nicola-milani/babybox/hardware/kicad/README.md

# Schema KiCad

Mettere qui il progetto KiCad (`.kicad_pro`, `.kicad_sch`). Per la 1.0 serve solo lo schema, usato come riferimento per il montaggio su millefori. La PCB è fase successiva (M6).

Esportare anche un PDF dello schema in questa cartella a ogni modifica, così si legge senza KiCad.
