nicola-milani/babybox/PIANO_DI_LAVORO.md

# Piano di lavoro — consegna venerdì 20 novembre 2026

Partenza: sabato 17 ottobre 2026. Aggiornato **domenica 18 ottobre, sera**:
mancano **33 giorni**, poco meno di cinque settimane. L'ordine parte
**martedì 20**.

## Cosa significa "pronto" il 20 novembre

Un box completo e funzionante (milestone M1–M5 in versione essenziale):

- case in PETG chiuso, elettronica su millefori, batteria 18650 con ricarica USB-C;
- almeno **5 carte** con storie registrate e **3 dischi** con canzoni;
- firmware: carte, pausa/ripresa, cursore volume, tasti, deep sleep, web UI in italiano con pagina casa, controllo genitori;
- test d'uso con un bambino superato; repository pubblico con README e STL.

**Fuori dal 20 novembre** (dopo la 1.0): PCB custom, M6 kit per altre famiglie, esportazione "personaggio" in TAR se il tempo stringe.

**Non si fa:** nessuna pull request verso ESPuino o altri progetti altrui. Correzioni e traduzione restano nel fork.

## Dove siamo, in due righe

Il software è **avanti di due settimane** sul piano; l'hardware **non è ancora
partito**, perché l'ordine non è stato fatto. Tutto il rischio della consegna
si è concentrato in un punto solo: la data in cui arrivano i pezzi.

### Fatto nel fine settimana (17–18 ottobre)

| | |
| --- | --- |
| Repository | Progetto e fork di ESPuino, pubblici, con licenze (GPL-3.0 e CC BY-SA 4.0). 19 + 9 commit |
| Firmware | **Compila** per ESP32-S3 N16R8: RAM 15,3 %, flash 46,6 %, zero avvisi |
| Task 3 · italiano | **Finito** (era previsto per la settimana 1): 0 etichette non tradotte su 2426 |
| Task 6 · controllo genitori | **Software finito** (era previsto per la settimana 3): logica con 47 verifiche, innesto nel firmware, pagina web. Manca la prova sul box |
| Modelli 3D | **18 STL pronti**: cubo in 8 pezzi, disco, i due raccoglitori, provino NFC, calibro parti piccole, **più la console v2 in 5 pezzi** |
| Console v2 | **Completa e alla pari col cubo** (18 ott, sera): sostegni interni, sede della ferrite, paracolpi in TPU, interruttore e tasto genitori sul retro, porticina USB sua, carta che entra tutta con la tacca di estrazione. `verifica-ingombri.py` confronta 21 volumi e dà zero collisioni |
| Progetto elettrico | Lista d'ordine, schema di cablaggio, pinout chiuso |
| Banco di prova | Verifiche che girano sul Mac in un secondo; web UI navigabile senza hardware |
| Mockup | Pagina "casa" per i genitori, provabile dal telefono |
| Display | **Tolto** (18 ott): −12/18 € per box, −1 settimana di lavoro, +6 GPIO liberi, fronte del case chiuso |
| Carte | **Statuine → carte CR80 comprate** (18 ott): niente stampa, niente pausa M600, niente tag da incollare. Vassoio del coperchio rifatto rettangolare, 88 × 62, accetta carta e disco |
| Retro | microSD **dentro** il case; fuori resta la USB-C dietro una **porticina scorrevole** che non si sfila |
| Raccoglitori | Due pezzi nuovi a incastro sulle fiancate: **6 carte + 6 dischi** in vista, e il box da solo resta largo 130 |
| LED di stato | **Un WS2812** dietro una finestrella da 0,8 mm: batteria, WiFi, modo. ESPuino lo pilota già; alimentato da GPIO per non rovinare il deep sleep |
| Fuori casa | **Modalità configurazione** con pressione lunga sul tasto genitori: apre la rete del box e lo dice a voce |

### Non fatto, e blocca tutto

- [ ] **Ordinare i componenti martedì 20** (`hardware/ordine.md`). Lista per **un pezzo solo**, divisa per conseguenza del guasto: nove voci su Amazon (percorso critico delle settimane 1–2, più batteria e microSD dove il rischio è sicurezza e dati), il resto su AliExpress filtrando i venditori con magazzino in Europa. **143–208 € in tutto**, filamento compreso. La lista non dipende dalla scelta fra cubo e console: ferrite e TPU sono gli unici pezzi della sola console
- [ ] Stampare provino NFC e calibro parti piccole
- [ ] Confermare l'elenco delle 5 storie e 3 canzoni
- [ ] Installare l'estensione PlatformIO in VS Code (per compilare senza riga di comando)

## Il rischio principale: l'ordine non è ancora partito

Era il rischio numero uno del piano, e si è avverato in parte. Oggi, 18 ottobre:

- **Amazon** (parte A: scheda, lettore, batteria, microSD, altoparlante, amplificatore, regolatore, portabatteria, LED): ordinando lunedì 19 arrivano **mercoledì 21 o giovedì 22**. Con questi soli si fanno tutte le prove delle settimane 1 e 2, M2 compresa.
- **AliExpress** (parte B: carte, tag, TP4056, cursore, tasti, minuteria, ferrite): 3–7 giorni dai venditori con magazzino in Europa, 10–30 dalla Cina. Serve dalla **settimana 3**, quando si monta davvero. Se tarda oltre il 10 novembre si monta lo stesso: i tasti si simulano con un filo, la cella si carica a parte, le viti di sicurezza si rimpiazzano con le M2,5 del kit. L'unica voce senza rimpiazzo sono le carte — se si vuole un paracadute, quelle si prendono su Amazon per 8–14 € invece che per 4–7.

**Se l'ordine slitta di una settimana**, M1 slitta con lui e il piano perde il
suo margine: resta la 1.0, ma senza test di autonomia e senza il secondo giro
di stampa del case.

## Settimana per settimana (riscritto)

| Settimana | Firmware (io) | Hardware / 3D (tu) | Contenuti (tu) | Uscita (gate) |
| --- | --- | --- | --- | --- |
| ~~0 · 17–18 ott~~ | ~~fork, compilazione~~ **+ task 3 e 6** | ordine **da fare** | elenco **da fare** | ✅ firmware compila |
| **1 · 19–25 ott** | Pagina "casa" vera; sfoltire la web UI; fuso orario in memoria; modulo DS3231 | **Ordine martedì 20.** Stampa provino NFC, calibro, un disco. Breadboard appena arrivano i pezzi | Elenco definitivo; registrare 2 storie | **M1:** carta → storia in meno di 1 s |
| **2 · 26 ott–1 nov** | Task 1: cursore, tasti, deep sleep, taratura batteria. Prova dell'LPCD e della modalità configurazione | Alimentazione su breadboard; stampa case v1 e i due raccoglitori | Altre 2 storie; suoni di sistema, compresa «modalità configurazione» | **M2:** sleep < 1 mA **col LED alimentato da GPIO**, batteria ±3 punti. **Avviare il test di autonomia** |
| **3 · 2–8 nov** | Task 8 (dischi); prova sul banco del task 6 + dissolvenza; annuncio vocale della batteria; colori del LED | Correzioni → case v2; dischi col tag (pausa M600); adesivi sulle carte | 5ª storia; 3 canzoni; messaggi della nanna | Blocco nanna vero sul box |
| **4 · 9–15 nov** | Task 7 (export/import); task 5 (allineamento ESPuino); OTA | Montaggio su millefori dentro il case; verifiche del prototipo | Normalizzazione a −16 LUFS | **M3 + M4:** carta associata dal telefono in 30 s; verifiche superate |
| **5 · 16–20 nov** | Solo correzioni. **Freeze mercoledì 18** | Ritocchi, verniciatura EN 71-3 | — | **M5:** test con un bambino, README, release venerdì 20 |

M3 (firmware) e M4 (case) vanno in parallelo dalla settimana 2.

## Cosa dice lo stato del box, adesso che non c'è lo schermo

| Chi | Come |
| --- | --- |
| Il genitore | Web UI: cosa suona, traccia, batteria, se è in fascia di riposo |
| Il bambino | La carta che ha in mano: non sa leggere, l'adesivo gli dice più di un titolo |
| Batteria scarica | **Annuncio vocale**, funzione già presente in ESPuino: va accesa dalla web UI e serve il file in `/sistema` (task 4) |
| Riposo bloccato | Il messaggio della nanna registrato dai genitori (task 6) |
| Primo avvio e indirizzo | Pagina del primo avvio (task 9), e il comando «annuncia l'indirizzo IP» |
| Batteria, WiFi, modo | **Il LED RGB sul fronte**: ESPuino mostra già il livello di batteria al risveglio e lo stato del WiFi |
| Rete del box aperta | Suono «modalità configurazione» più il LED, quando si tiene premuto il tasto genitori |

## Lavoro firmware rimasto, in ordine di priorità

| | Cosa | Serve hardware? | Quando |
| --- | --- | --- | --- |
| 1 | **Task 1**: cursore a slitta, tasti, deep sleep, taratura della batteria | sì | sett. 1–2 |
| 2 | **Pagina "casa"** dal mockup, e sfoltire la web UI di ESPuino | no | sett. 1 |
| 2b | **Colori del LED per la nanna**: ESPuino non ha questo stato, va aggiunto | no | sett. 3 |
| 3 | **Fuso orario in memoria** (oggi è compilato nel firmware) e primo avvio | no | sett. 1 |
| 4 | **Modulo DS3231**: ESPuino non lo supporta, usa l'RTC interno via NTP | si scrive senza, si prova con | sett. 1–2 |
| 5 | ~~Task 2: display e-paper~~ **annullato il 18 ottobre** | — | — |
| 6 | **Task 8**: tipo del tag e flusso "nuovo disco" | in parte | sett. 3 |
| 7 | **Dissolvenza** negli ultimi 30 s: il controllo genitori la chiede già, il player non la fa | sì | sett. 3 |
| 8 | **Task 7**: esporta e importa la configurazione in JSON | no | sett. 4 |
| 9 | **Task 5**: primo allineamento col master di ESPuino | no | sett. 4 |
| 10 | **OTA**: aggiornamento dal browser | sì | sett. 4 |

## Due forme, si sceglie quando arrivano i pezzi

Il 18 ottobre, visto che la stampa non era ancora partita, la **console da
viaggio** di `docs/varianti/v3-console-da-viaggio.md` è stata modellata per
intero invece che tenuta da parte: 180 × 110 × 45, carta che entra di lato
corto lasciando fuori un centimetro, vano della collezione sul retro,
paracolpi in TPU (`modelli-3d/v2-console/`, 4 STL).

Oggi le due forme sono alla pari: stessa elettronica, stesso firmware,
sostegni interni completi in entrambe e `verifica-ingombri.py` che dà zero
collisioni sulla console. Restano due incognite, tutte e due della console e
tutte e due da chiudere col lettore in mano:

- una CR80 infilata tutta si legge, e il bambino riesce a tirarla fuori dalla tacca?
- con la ferrite dietro l'antenna, le carte riposte nel vano restano zitte?

Sono dieci minuti col provino NFC. **Quello che cambia oggi è l'ordine**: va
aggiunto il foglio di ferrite (A13, 5–9 €) e 500 g di TPU, altrimenti la
porta si chiude da sola. La decisione su cosa stampare si prende in
settimana 2, dopo la prova.

## Margini e piano B

- Se il PN5180 non arriva o l'LPCD non sveglia il box: RC522 per il prototipo, senza risveglio all'appoggio. Si decide in settimana 2.
- ~~Se l'e-paper slitta~~: non serve più un piano B, il display è stato tolto dal progetto (vedi `tasks/task-02-display-epaper.md`).
- Se il DS3231 non arriva in tempo: si resta sull'RTC interno con NTP. Il controllo genitori funziona lo stesso, ma un box riacceso lontano dal WiFi parte con la regola più restrittiva.
- Se il test di autonomia (10 h) non è chiuso: va comunque avviato in settimana 2, perché richiede una giornata intera.
- Se i contenuti sono in ritardo: la 1.0 può uscire con 3 storie invece di 5. È l'unico taglio che non tocca il firmware né il case.
