nicola-milani/babybox/docs/roadmap.md

# Roadmap

Si passa alla milestone successiva solo quando il criterio di uscita è verificato. M3 e M4 possono andare in parallelo.

| Milestone | Contenuto | Criterio di uscita | Settimana (piano 20 nov) |
| --- | --- | --- | --- |
| M1 · Prototipo su breadboard | Audio da SD, lettura NFC, associazioni; ESPuino su ESP32-S3 con PN5180 | La carta avvia la storia in meno di 1 s | 1 |
| M2 · Batteria e comandi | Alimentazione, cursore volume, tasti, deep sleep, livello batteria | 10 h di ascolto, sleep sotto 1 mA | 2 |
| M3 · Web UI e controllo genitori | Web UI in italiano, controllo genitori, pagina casa, dischi, backup (task 3, 6, 7, 8, 9) | Nuova carta associata da telefono in 30 s | 3–4 |
| M4 · Case e carte | Case PETG, carte e dischi con tag, montaggio su millefori | Tutte le verifiche del prototipo superate | 2–4 |
| M5 · Versione 1.0 | OTA, documentazione, repository pubblico, test d'uso | Release 1.0 pubblicata | 5 |
| M6 · Kit (facoltativa) | PCB KiCad, ordine di gruppo, firmware installabile dal browser | Un genitore esterno monta il kit da solo | dopo il 20 nov |
