nicola-milani/babybox/tasks/task-01-configurazione-base.md

# Task 1 · Configurazione di base (M1 e M2)

Portare ESPuino sull'ESP32-S3 N16R8 con i pin di `hardware/pinout.md` e le opzioni di `firmware/config/impostazioni-box.md`.

**Già fatto (17 ottobre):** i tre file di configurazione esistono in `firmware/config/` e si applicano con `./firmware/applica-config.sh`. In ESPuino 3.1 LPCD, pausa togliendo il tag e salvataggio della posizione sono impostazioni della web UI, non `#define`: quello che resta da fare qui è la prima compilazione, la lettura del cursore, la taratura della batteria e i due punti aperti (pin microSD, GPIO48).

## Gesti del bambino (solo pressione breve)
- Cursore = volume, da sinistra (piano) a destra (forte).
- Tasto avanti / indietro = traccia successiva / precedente.
- Togliere la carta = pausa.
- Nessuna pressione lunga o combinazione di tasti.

## Lettura del cursore
- Potenziometro su ADC (GPIO2), alimentato da GPIO42 solo quando il box è sveglio.
- Lettura ogni 50 ms con media e isteresi, niente tremolio.
- Corsa intera = 0 → massimo impostato. Il volume della web UI diventa un **limite**, non un valore assoluto.

## Gesti del genitore
- Tasto incassato sul fondo = attiva/disattiva modalità setup. Tutto il resto dalla web UI.

## Accettazione
- [ ] La carta avvia la storia in meno di 1 s
- [ ] Togliendola va in pausa; rimettendola riparte dal punto salvato
- [ ] Appoggiandola a box addormentato il box si sveglia
- [ ] Un bambino di 2 anni usa cursore e tasti senza aiuto
- [ ] La percentuale di batteria non oscilla più di 3 punti
- [ ] Deep sleep sotto 1 mA (misurato col multimetro)
