nicola-milani/babybox/tasks/task-05-allineamento-espuino.md

# Task 5 · Allineamento con ESPuino

Una volta al mese:
1. Unire il master di ESPuino nel `main` del fork.
2. Compilare.
3. Ripetere su un box di test le verifiche del task 1.
4. Solo allora aggiornare gli altri box via OTA.

Primo allineamento: settimana 4 (9–15 novembre), prima del freeze.
