nicola-milani/babybox/hardware/lista-acquisti.html

# Spesa del 20 ottobre

Un box solo, niente scorte. Prezzi visti il 19 ottobre 2026: cambiano.

0 di 0 presi 156–226 €

## L'altoparlante è l'unico pezzo che non si trova

Il case è disegnato su un Ø40 alto 6 mm. I «40 mm 4 Ω 3 W» che si trovano su Amazon sono alti 18–20 mm: nella console non ci stanno, il guscio anteriore è profondo 26 e il tubo ne occupa 12.

Serve il tipo ultrasottile, quello dei tablet: su AliExpress si trova, su Amazon quasi mai. Siccome sta sul percorso critico, prenderei il sottile su AliExpress e uno qualsiasi su Amazon come riserva. Limite da rispettare: spessore ≤ 10 mm.

Lista completa con le note di scelta in hardware/acquisti.md; il perché delle quantità e della divisione fra i due negozi in hardware/ordine.md. Appena arriva la parte A: misurare altoparlante, PN5180 e portabatteria col calibro, rigenerare gli STL, e provare l'LPCD — è la domanda che decide il piano B.
