nicola-milani/babybox/tasks/README.md

# Task firmware

Un file per task. Con Claude Code: passa il file del task, `CLAUDE.md` e `hardware/pinout.md`, e chiedi **per prima cosa i test di accettazione**.

Ordine e settimane in `../PIANO_DI_LAVORO.md`.

| Task | Stato al 18 ottobre |
| --- | --- |
| 1 · configurazione di base | da fare, serve l'hardware |
| 2 · display e-paper | **annullato** il 18 ottobre (il file spiega perché) |
| 3 · italiano nella web UI | **fatto** |
| 4 · registrazioni | da fare (non è firmware) |
| 5 · allineamento ESPuino | settimana 4, poi mensile |
| 6 · controllo genitori | **software fatto**, manca la prova sul box |
| 7 · esporta e importa | da fare, non serve hardware |
| 8 · musica e dischi | da fare |
| 9 · pagina "casa" | nuovo: mockup pronto, pagina da scrivere |
