nicola-milani/babybox/hardware/bom.csv

rif | componente | modello_consigliato | qta_per_box | qta_da_ordinare | prezzo_indicativo_eur | fornitore | note
A1 | Microcontrollore | ESP32-S3-DevKitC-1 N16R8 (16MB flash 8MB PSRAM octal) | 1 | 1 | 12-20 | Amazon | Se e' morto o e' la sigla sbagliata non parte niente; verificare N16R8 e PSRAM octal
A2 | Lettore NFC | PN5180 SPI con antenna sul PCB | 1 | 1 | 9-14 | Amazon | Il pezzo piu' incerto: va provato in settimana 1 perche' il piano B (RC522) si decide in settimana 2. Case disegnato su 58x47x8
A3 | Batteria | 18650 Samsung 35E (3500) o 30Q (3000) o 29E (2900) nuova - non reclaimed | 1 | 1 | 4-14 | nkon.nl o Amazon | Cella nuda da mettere nel portabatteria | non un pacco precablato. Con il carico su OUT+/OUT- del TP4056 la protezione c'e' comunque; protetta e' cintura e bretelle. Non si compra in Cina
A4 | MicroSD | 32 GB classe 10 | 1 | 1 | 6-9 | Amazon | Le contraffatte dichiarano 32 GB e ne hanno 8; formattare FAT32
A5 | Altoparlante | 4 ohm 3W diametro 40 mm altezza max 6 mm | 1 | 1 | 6-10 | Amazon | Il case e' disegnato su D40x6 e da Amazon si puo' rimandare indietro; misurare appena arriva
A6 | Amplificatore | MAX98357A I2S 3W | 1 | 1 | 6-10 | Amazon | Senza non si sente niente in settimana 1; alimentato da VBAT non da 3V3
A7 | Regolatore 3.3V | ME6211C33 o AP2112K-3.3 (500-600 mA) | 1 | conf. da 5 | 5-8 | Amazon | Serve a M2: il deep sleep sotto 1 mA non si misura sulla DevKit alimentata da USB. Evitare AMS1117 e HT7333
A8 | Portabatteria | Supporto 18650 contatti a molla | 1 | conf. da 2-5 | 5-7 | Amazon | Serve al test di autonomia della settimana 2; alla cella non si salda mai direttamente. Culle disegnate su 24x78x20
A9 | LED di stato | WS2812B singolo su breakout o striscia da tagliare | 1 | 1 | 6-8 | Amazon | M2 chiede il deep sleep col LED alimentato: senza non vale la misura. Alimentato da GPIO
B1 | Carte delle storie | Carte PVC CR80 con NTAG213 (85.6x54) | 1 per storia | 10 | 4-7 | AliExpress | Cinque bastano alla 1.0; se si vuole un paracadute sui tempi si prendono su Amazon a 8-14
B2 | Tag per i dischi | NTAG213 adesivi 25 mm | 1 per disco | conf. da 20-50 | 4-6 | AliExpress | NTAG213 (ISO 14443A): non NTAG215/216 amiibo | non Mifare Classic
B3 | Modulo carica | TP4056 USB-C 6 pin con protezione DW01 | 1 | conf. da 5 | 2-4 | AliExpress | USB-C non micro-USB; la versione a 6 pin ha la protezione
B4 | Cursore volume | Potenziometro a slitta lineare B10K corsa 60 mm | 1 | 1-2 | 2-4 | AliExpress | Lineare (B); misurare corpo e levetta appena arriva
B5 | Tasti | Pulsanti arcade 30 mm bassa forza | 2 | 2 | 3-5 | AliExpress | Due colori: indietro e avanti; verificare il foro di montaggio (28 o 30 mm)
B6 | Lettore microSD | Modulo microSD 3.3V nativo o portacard nudo | 1 | conf. da 5 | 2-3 | AliExpress | NON i moduli con AMS1117 + 74LVC125 (sono per 5V)
B7 | Interruttore | Slitta da pannello SS12D00 | 1 | conf. da 10 | 1-3 | AliExpress | Incassato sul retro (console) o nel fondo (cubo)
B8 | Ferrite schermante | Foglio di ferrite flessibile adesivo 60x60 mm sp. 0.3-0.5 mm | 1 | 1 | 2-4 | AliExpress | Serve SOLO alla console v2; ritagliare 5-10 mm piu' grande della spira per lato
B9 | Tasto genitori | Micropulsante 6x6 mm | 1 | conf. da 20 | 1-2 | AliExpress | Incassato in un pozzetto da 6 mm
B10 | Passivi | 100k 1% / 100 nF / 10 uF / 220 uF / 10k | 1 set | kit | 3-5 | AliExpress | Partitore batteria pull-up SD e condensatori di serbatoio
B11 | Basetta | Millefori 70x90 mm doppia faccia | 1 | conf. da 5 | 2-4 | AliExpress | Da 70x90 si ricava sia la basetta del cubo sia quella della console (36x80)
B12 | Minuteria | Inserti a caldo M2.5 e viti M2.5 | 1 set | kit | 4-6 | AliExpress | Servono dalla settimana 3
B13 | Cablaggio | Cavetto siliconico 26 AWG e connettori JST-XH | 1 set | kit | 3-5 | AliExpress
B14 | Varie | Rete anti-polvere e biadesivo 3M VHB | 1 set | 1 | 2-3 | AliExpress | Rete dietro la griglia dell'altoparlante
B15 | Viti di sicurezza | Torx pin o triwing M2.5x8 | 4 | conf. da 20 | 3-5 | AliExpress | Se tardano si usano le M2.5 del kit B12
B16 | Orologio | Modulo RTC DS3231 | 1 | 1 | 2 | AliExpress | Opzionale: ESPuino usa l'RTC interno via NTP
C1 | Filamento | PETG bianco per il case | ~150 g | 1 kg | 25 | negozio o Amazon | Dalla Cina non conviene: pesa e la spedizione si mangia il risparmio
C2 | Filamento TPU | TPU 95A per i paracolpi degli angoli | ~20 g | 500 g | 15 | negozio o Amazon | Solo console v2. Stampare lento (20 mm/s) e senza retrazione
C3 | Filamento PLA | PLA per provino NFC calibro e dischi | ~80 g | se gia' in casa | 0-20 |  | Non critico: va bene qualsiasi avanzo
