nicola-milani/babybox/modelli-3d/case/stl/scocca.stl

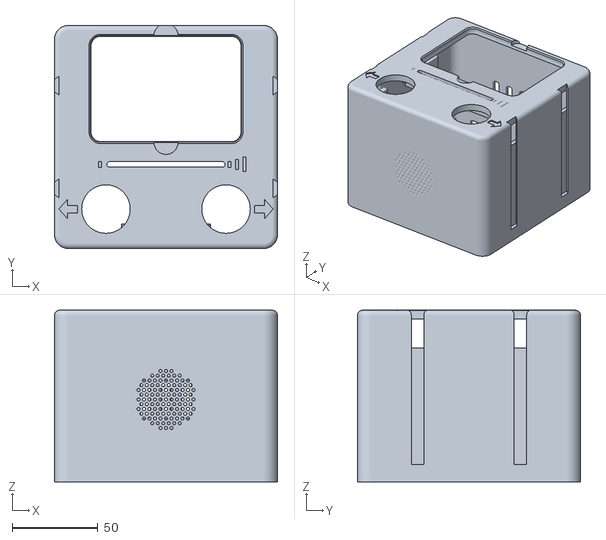
[picture p5: CAD file, 2026-10-18]
modelli-3d/case/stl/scocca.stl
130.0 x 130.0 x 100.0
