nicola-milani/babybox/modelli-3d/provini/stl/provino-nfc.stl

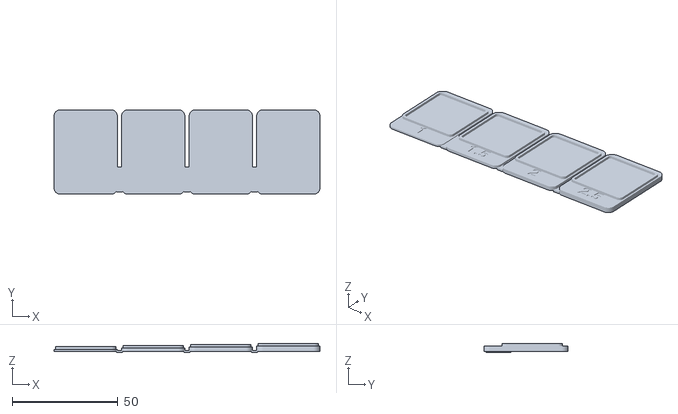
[picture p6: CAD file, 2026-10-17]
modelli-3d/provini/stl/provino-nfc.stl
126.0 x 40.0 x 4.20
