nicola-milani/babybox/modelli-3d/raccoglitori/stl/raccoglitore-carte.stl

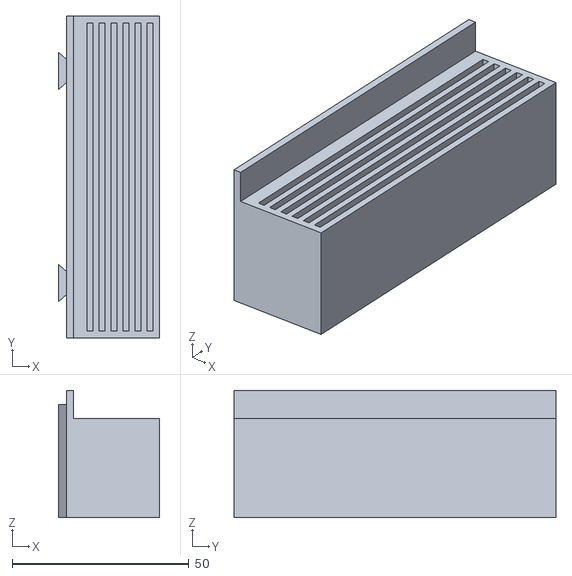
[picture p7: CAD file, 2026-10-18]
modelli-3d/raccoglitori/stl/raccoglitore-carte.stl
28.7 x 91.1 x 36.0
