nicola-milani/babybox/modelli-3d/v2-console/stl/retro-v2.stl

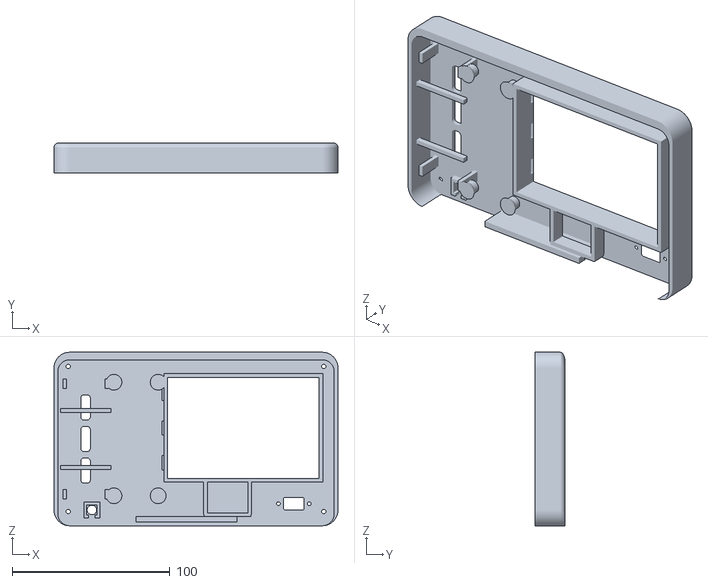
[picture p8: CAD file, 2026-10-18]
modelli-3d/v2-console/stl/retro-v2.stl
180.0 x 19.0 x 110.0
