nicola-milani/babybox/modelli-3d/vinili/stl/vinile.stl

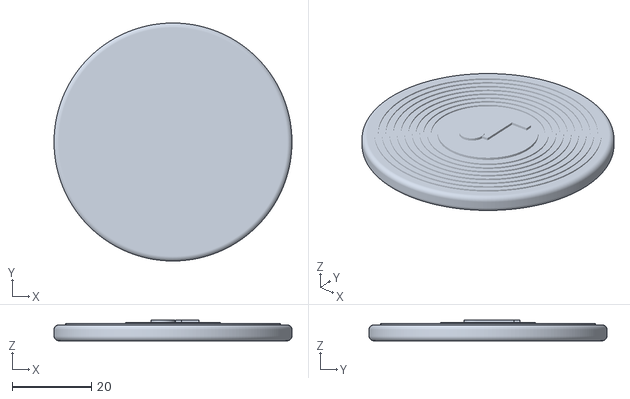
[picture p9: CAD file, 2026-10-17]
modelli-3d/vinili/stl/vinile.stl
60.0 x 60.0 x 5.19
