nicola-milani/babybox/modelli-3d/case/stl/sportello-usb.stl

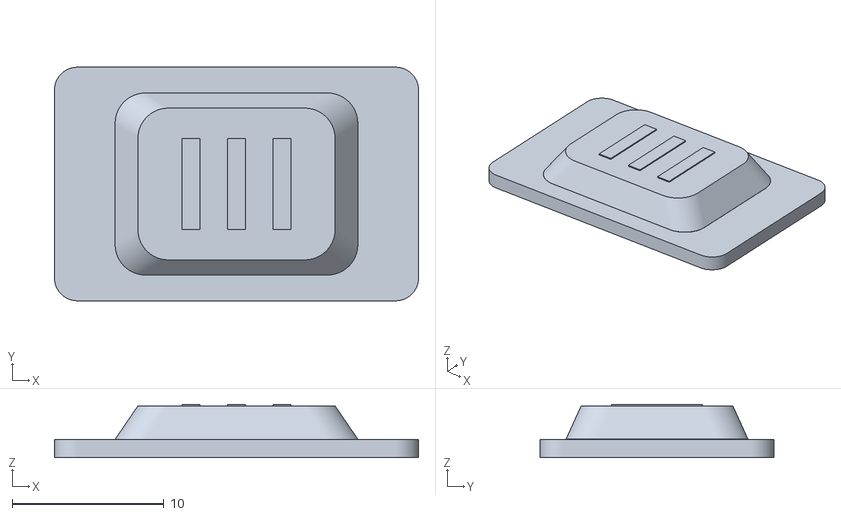
[picture p10: CAD file, 2026-10-18]
modelli-3d/case/stl/sportello-usb.stl
24.0 x 15.4 x 3.50
