nicola-milani/babybox/modelli-3d/provini/stl/calibro-parti-piccole.stl

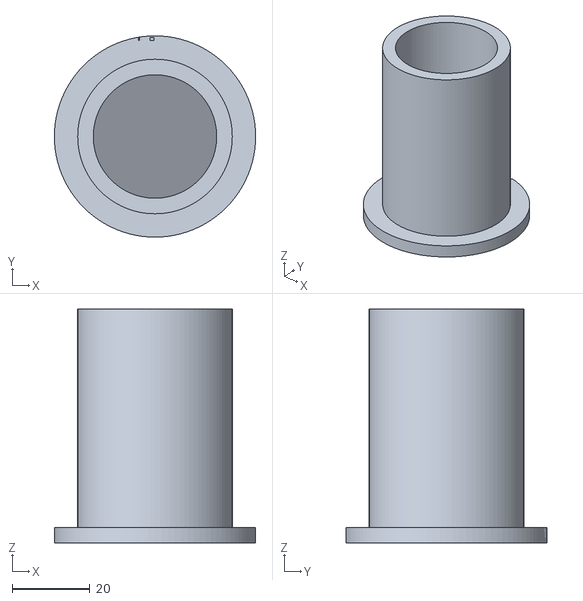
[picture p11: CAD file, 2026-10-17]
modelli-3d/provini/stl/calibro-parti-piccole.stl
51.7 x 51.7 x 60.1
