nicola-milani/babybox/modelli-3d/raccoglitori/stl/raccoglitore-dischi.stl

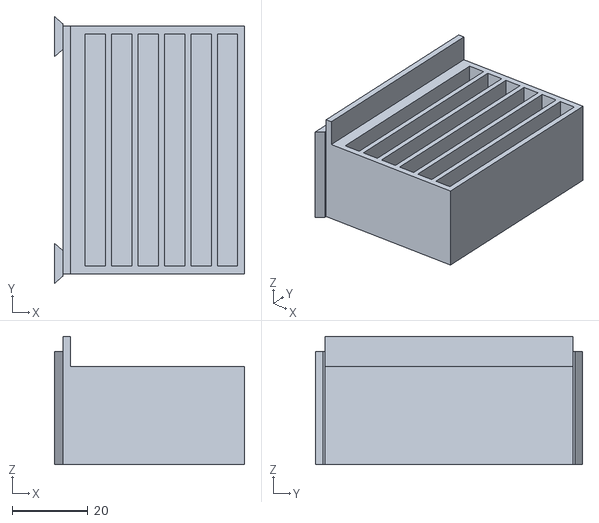
[picture p12: CAD file, 2026-10-18]
modelli-3d/raccoglitori/stl/raccoglitore-dischi.stl
50.3 x 70.7 x 34.0
