nicola-milani/babybox/modelli-3d/v2-console/stl/scocca-v2.stl

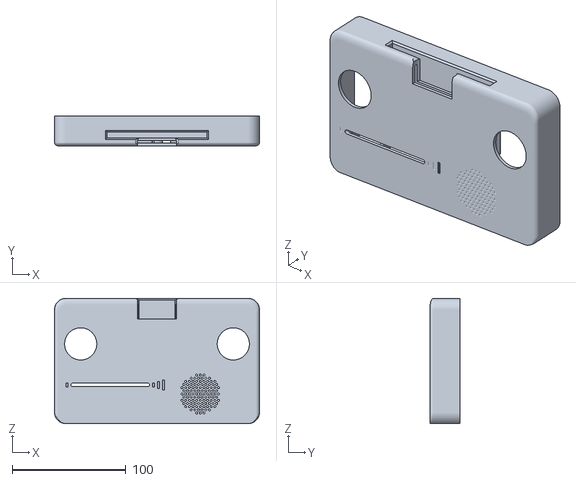
[picture p13: CAD file, 2026-10-18]
modelli-3d/v2-console/stl/scocca-v2.stl
180.0 x 26.0 x 110.0
