nicola-milani/babybox/modelli-3d/case/stl/piatto-nfc.stl

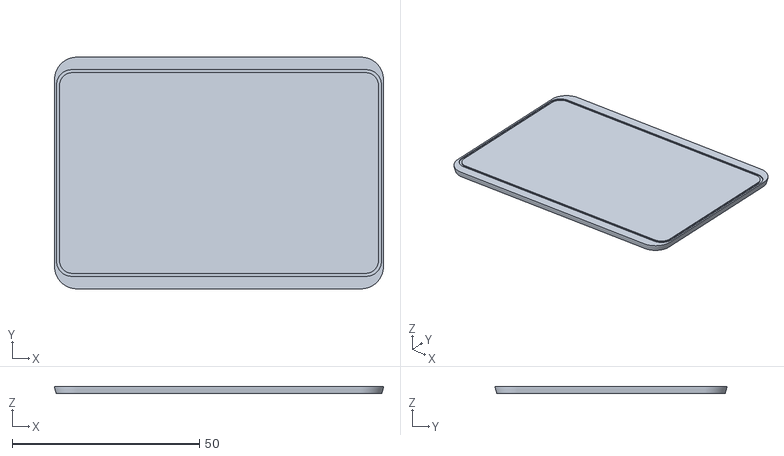
[picture p14: CAD file, 2026-10-18]
modelli-3d/case/stl/piatto-nfc.stl
87.9 x 61.9 x 2.00
