nicola-milani/babybox/modelli-3d/v2-console/stl/paracolpi-v2.stl

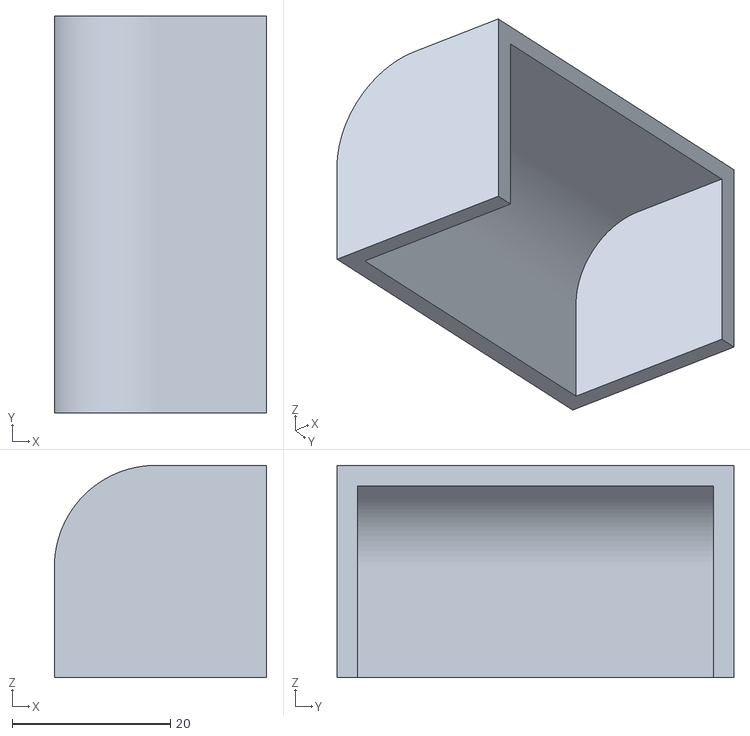
[picture p15: CAD file, 2026-10-18]
modelli-3d/v2-console/stl/paracolpi-v2.stl
26.8 x 50.2 x 26.8
