nicola-milani/babybox/modelli-3d/case/stl/sportellino-batteria.stl

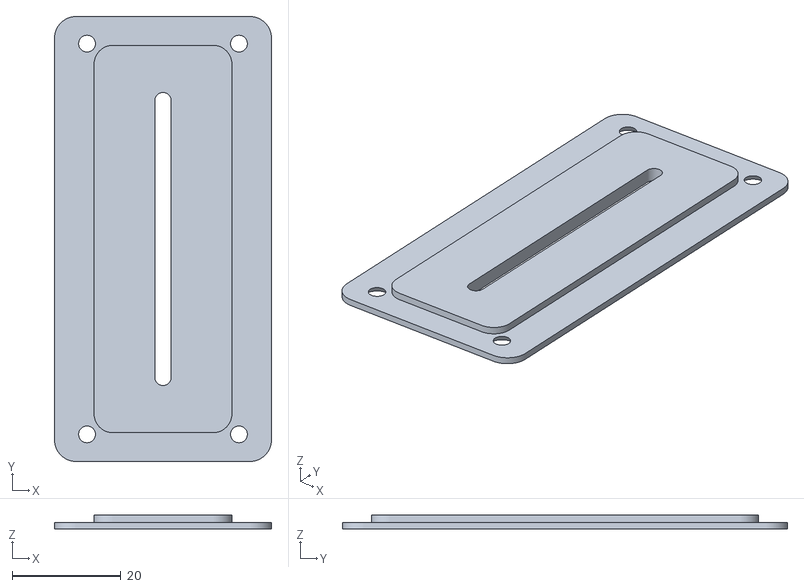
[picture p16: CAD file, 2026-10-17]
modelli-3d/case/stl/sportellino-batteria.stl
40.0 x 82.0 x 2.50
