nicola-milani/babybox/modelli-3d/v2-console/stl/sportello-usb-v2.stl

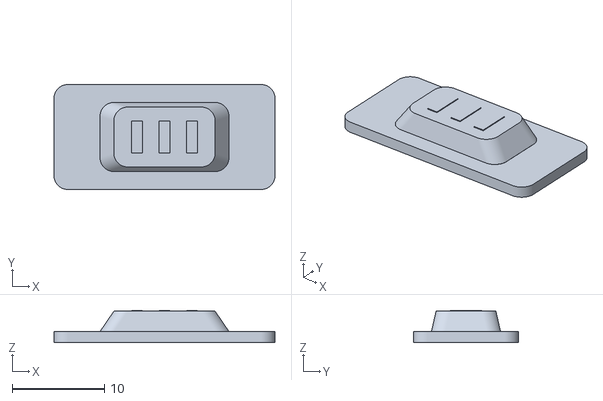
[picture p17: CAD file, 2026-10-18]
modelli-3d/v2-console/stl/sportello-usb-v2.stl
24.0 x 11.4 x 3.50
