nicola-milani/babybox/modelli-3d/case/stl/fondo.stl

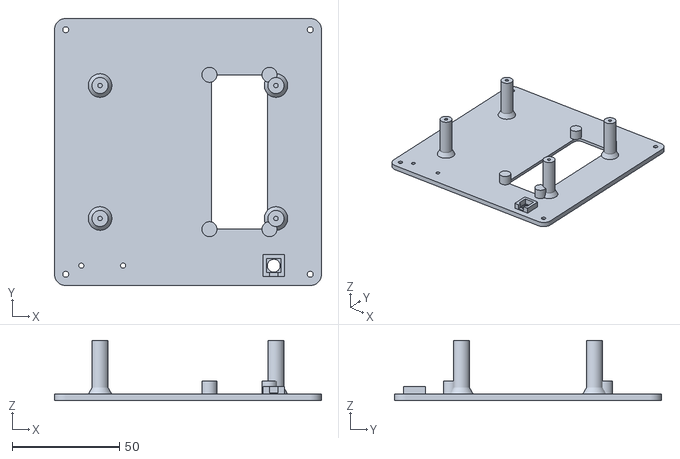
[picture p18: CAD file, 2026-10-17]
modelli-3d/case/stl/fondo.stl
124.5 x 124.5 x 28.0
