nicola-milani/babybox/modelli-3d/v2-console/stl/coperchio-vano.stl

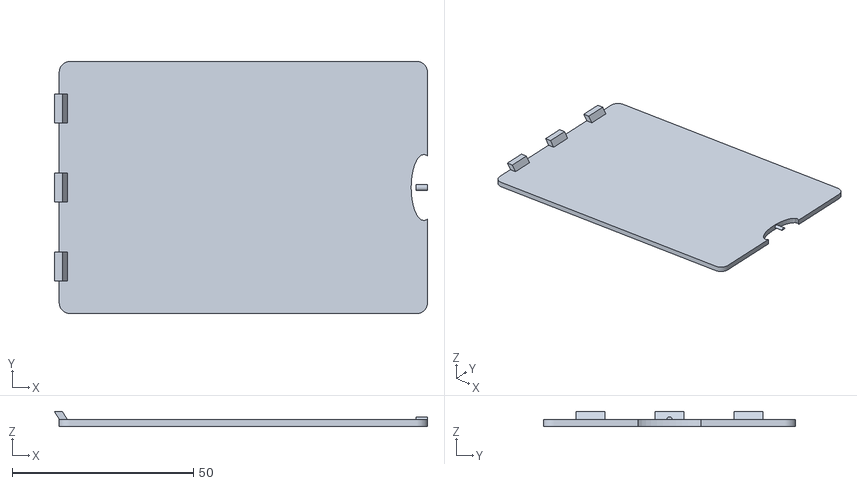
[picture p19: CAD file, 2026-10-18]
modelli-3d/v2-console/stl/coperchio-vano.stl
102.8 x 69.5 x 4.00
