nicola-milani/babybox/modelli-3d/case/stl/camera-altoparlante.stl

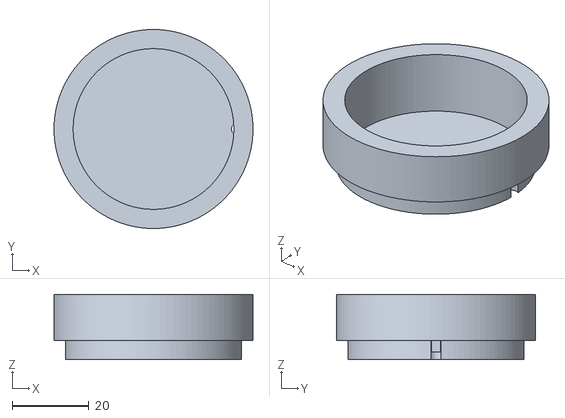
[picture p20: CAD file, 2026-10-17]
modelli-3d/case/stl/camera-altoparlante.stl
52.0 x 52.0 x 17.0
