nicola-milani/babybox/modelli-3d/case/stl/culla-cursore.stl

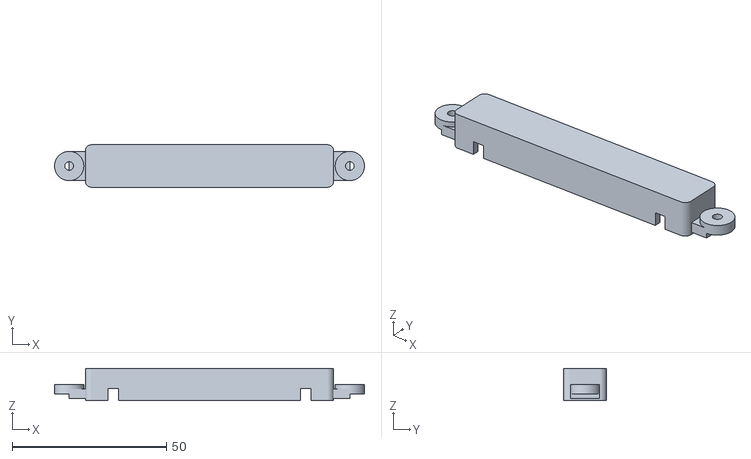
[picture p21: CAD file, 2026-10-17]
modelli-3d/case/stl/culla-cursore.stl
100.5 x 13.8 x 10.5
