nicola-milani/babybox/modelli-3d/case/stl/pomello-cursore.stl

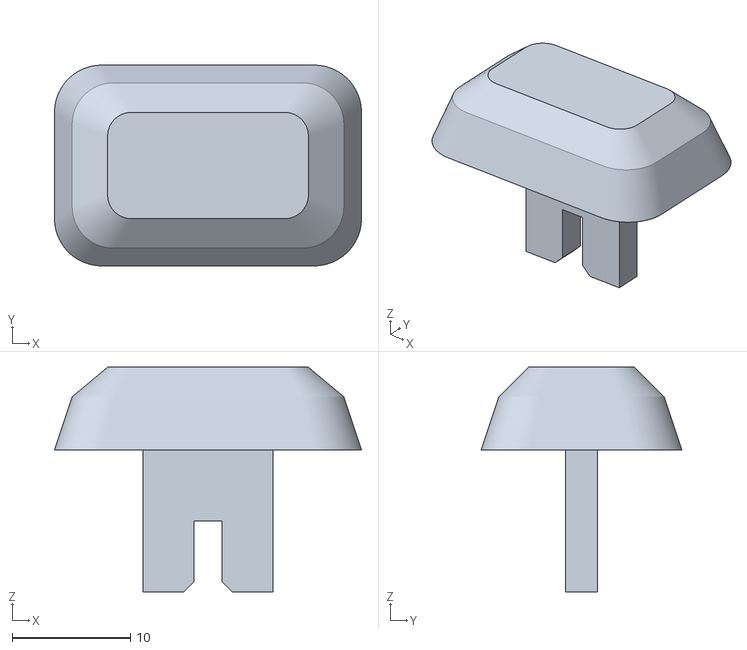
[picture p22: CAD file, 2026-10-17]
modelli-3d/case/stl/pomello-cursore.stl
26.0 x 17.0 x 19.0
