nicola-milani/babybox/modelli-3d/v2-console/sorgenti/parametri-v2.scad

// ============================================================
// parametri-v2.scad — console da viaggio (variante v2)
// ------------------------------------------------------------
// Alternativa al cubo: si tiene con due mani, carte e dischi si
// infilano in una fessura sul bordo superiore, la collezione sta
// in un vano sul retro.
//
// Le misure del cubo (parametri.scad) restano valide per tutto
// quello che non cambia: componenti, tolleranze, viti, cursore,
// tasti, altoparlante, LED. Qui c'è solo ciò che è diverso.
// ============================================================
include <../../sorgenti/parametri.scad>

// ---------- corpo ----------
V2_X         = 180;   // larghezza: due mani
V2_Z         = 110;   // altezza
V2_Y         = 45;    // spessore
V2_RAGGIO    = 10;    // raggio degli angoli, generoso: si prende e cade
V2_PARETE    = 2.4;
V2_SPLIT     = 26;    // a che profondità si dividono i due gusci (dal fronte)

// ---------- fessura ----------
// La carta entra di lato corto: così la spira del tag, che corre lungo il
// bordo della CR80, finisce tutta davanti all'antenna. Prima l'idea era
// infilarla di lato lungo per metà, e la lettura restava un'incognita.
V2_FESS_LARG  = CARTA_X + 2.4;      // 88,0: ci passa anche il disco Ø60
V2_FESS_SPESS = 5.4;                // carta 0,84, disco 4: passa tutto
// La carta entra tutta: fuori non resta niente. Per sfilarla c'e' una
// tacca sulla faccia, che scopre un pezzo della carta - si spinge su col
// pollice e si prende. Una carta che sporge e' la prima cosa che si piega
// in borsa, ed e' anche una leva in mano a un bambino.
// Per tornare alla carta sporgente basta rimettere V2_SPORGE = 10: tasca,
// antenna e tacca si risistemano da sole.
V2_SPORGE     = 0;                  // quanto resta fuori dalla fessura
V2_FESS_PROF  = CARTA_Y - V2_SPORGE + 1;  // 55: un millimetro di fondo corsa
V2_TACCA_X    = 34;                 // larghezza della tacca di estrazione
V2_TACCA_Z    = 18;                 // quanto scende dal bordo superiore
V2_IMBUTO     = 2.5;                // svasatura d'ingresso, per infilare al buio

// ---------- antenna e schermo ----------
V2_PN_Y       = 9;    // dove sta il PN5180, dal fronte

// ---------- comandi sul fronte ----------
V2_TASTO_X    = 67;   // sotto i pollici
V2_TASTO_Z    = 70;   // alti: sotto restano liberi i 52 mm della camera
// Altoparlante in basso e un po' a destra: sopra c'e' la tasca della
// fessura (la sua cava taglierebbe la camera acustica) e a sinistra passa
// il cursore. Fuori centro si nota appena, e il suono non cambia.
V2_ALT_X      = 38;
V2_ALT_Z      = 26;
V2_LED_X      = -62;  // fra la vite d'angolo e la tasca della fessura
V2_LED_Z      = 100;  // in alto a sinistra
// Il cursore del volume sta sulla faccia, in basso a sinistra, come sul
// cubo: con la griglia spostata a destra i 69 mm della sua corsa ci stanno.
V2_CURSORE_X  = -41;  // in basso a sinistra, lontano dalla camera acustica
V2_CURSORE_VITI = CURSORE_LUNG/2 + 4.5;   // dove si avvita la culla
V2_CURSORE_COLLARE = CURSORE_CORSA + 14;  // piu' stretto che sul cubo: il
                                          // bordo e' lungo 180 e il collare
                                          // largo non ci starebbe
V2_CURSORE_Z  = 34;   // sulla faccia, sotto i tasti e a sinistra della griglia

// ---------- vano della collezione, sul retro ----------
V2_VANO_X     = 96;   // di piatto ci stanno 6 carte, o 3 dischi
V2_VANO_Z     = 64;
V2_VANO_PROF  = 13;
V2_VANO_X0    = 30;   // spostato a destra: a sinistra c'è la batteria
V2_VANO_Z0    = 30;

// ---------- USB-C e porticina, sul bordo inferiore ----------
// Sotto il vano, non sotto la batteria: li' c'e' posto per il TP4056.
V2_USB_X      = 20;
// Il tunnel e' piu' largo che sul cubo (11 x 6) perche' qui la presa resta
// quattro millimetri dentro: deve passarci il guscio dello spinotto, non
// solo la punta.
V2_USB_W      = 13.0;
V2_USB_H      = 7.5;
// Porticina scorrevole, stessa idea del cubo ma piu' bassa: il bordo
// inferiore e' profondo 19 mm e la gola del cubo ne vuole 16, resterebbero
// due binari da 1,5 mm. Con 12 i binari sono 3,5 e tengono.
V2_SPORT_X1   = -32;  // la cava va da qui...
V2_SPORT_X2   = 20;   // ...a qui: 52 mm, la porticina ne occupa 24
V2_SPORT_APERTURA  = 9;    // fessura a vista
V2_SPORT_GOLA      = 12;   // cava interna: la porticina non si sfila
V2_SPORT_PROF_APE  = 1.6;
V2_SPORT_PROF_GOLA = 3.0;
V2_SPORT_PAD  = 3.4;  // ispessimento interno: 2,4 non bastano per la gola

// ---------- comandi dell'adulto, sul retro ----------
// Sul cubo interruttore e tasto genitori stanno sotto il fondo, dove la
// mano di un bambino non arriva mentre gioca. Qui un sotto non c'e':
// vanno sul retro, nella fascia sotto il vano, che quando la console e'
// appoggiata guarda il tavolo. Per premere il tasto genitori bisogna
// sollevarla, ed e' esattamente il gesto che serve.
V2_SW_X       = 62;   // interruttore generale, in basso a destra
V2_SW_Z       = 14;
V2_GEN_X      = -66;  // tasto genitori, in basso a sinistra
V2_GEN_Z      = 10;

// ---------- disposizione interna ----------
// La batteria sta in piedi lungo il fianco sinistro, a cavallo dei due
// gusci: da sola la meta' posteriore e' profonda 16,6 mm e il
// portabatteria ne vuole 20. Le culle la tengono da entrambe le parti,
// che per una versione da viaggio e' anche meglio.
// In orizzontale il portabatteria (78 mm) non ci starebbe: fra la parete
// sinistra e il vano della collezione ce ne sono 70. Quindi va in piedi.
V2_BATT_X     = -70;
V2_BATT_Z     = 55;
V2_BATT_Y     = 32;    // a cavallo dello stacco (26): la culla e' divisa
// I bracci della culla stanno a quota fissa, non a una frazione della
// lunghezza della cella: quello che li vincola non e' la cella ma lo spazio
// libero fra il tasto sinistro (che arriva a z 86,5) e il collare del
// cursore (che comincia a 26). Cosi' reggono sia il portabatteria da 78 sia
// una cella precablata da 72.
V2_BATT_BRACCI = 35;   // distanza dei bracci dal centro della cella
V2_BATT_FASCETTE = 18; // dove passano le fascette, nel guscio posteriore

V2_BASETTA_X  = 36;    // stretta: ci sta la DevKitC-1 (63 x 25) per il verso
V2_BASETTA_Z  = 80;    // lungo, con una decina di millimetri per i fili
V2_BASETTA_CX = -38;   // fra la batteria e il vano
V2_BASETTA_CZ = 55;
V2_BASETTA_Y  = 6;     // quanto sta sollevata dal fondo del guscio posteriore

V2_TP_X       = 20;    // modulo di ricarica, allineato alla presa
V2_TP_Z       = 18;    // alzato: sotto passa l'ispessimento della porticina

// ---------- ferrite ----------
V2_FERRITE_X  = 60;    // ritagliata piu' grande della spira dell'antenna
V2_FERRITE_Z  = 50;
V2_FERRITE_SP = 0.5;
