nicola-milani/babybox/(list of files, cad)

Other CAD files:
modelli-3d/v2-console/sorgenti/scena-v2.scad
modelli-3d/v2-console/sorgenti/sportello-usb-v2.scad
