nicola-milani/babybox/test/checklist-prototipo.md

# Checklist di verifica

## M1 · Breadboard
- [ ] Carta → storia in < 1 s
- [ ] Pausa togliendo, ripresa rimettendo

## M2 · Batteria e comandi
- [ ] Deep sleep < 1 mA
- [ ] Risveglio appoggiando la carta (LPCD)
- [ ] Autonomia ≥ 10 h a volume medio (test di una giornata: avviarlo presto)
- [ ] Batteria stabile ±3 punti
- [ ] Cursore senza tremolio; tutto a destra = limite genitori

## M4 · Prototipo nel case
- [ ] Distanza di lettura NFC attraverso il piatto (2 mm) con la carta appoggiata
- [ ] Lo stesso con un disco, che ha il tag 1 mm più in alto
- [ ] Carta e disco restano fermi nel vassoio, e si sollevano dalle tacche
- [ ] Temperatura interna dopo 2 h di riproduzione + ricarica contemporanee
- [ ] Caduta da 1 m sul pavimento
- [ ] Nessuna parte passa dal cilindro per parti piccole (Ø 31,7 mm): dischi, pomello, sportello USB, raccoglitori

## M5 · Test d'uso
- [ ] Bambino di 2 anni usa carte, cursore e tasti senza aiuto
- [ ] Associazione nuova carta da telefono < 30 s
- [ ] Disco nuovo → canzone in < 60 s
- [ ] Fascia nanna: seconda storia bloccata con messaggio
