nicola-milani/babybox/test/webui-locale/mockup-casa.html

Sta raccontando «La volpe e il bosco» Capitolo 2 di 5, volume 6

74% circa 7 ore WiFi casa

🧸 Nuova statuinaAppoggiala e scegli la storia 🎵 Nuovo vinileAppoggialo e scegli la canzone 🌙 NannaBlocca adesso, o imposta le fasce Carica storieDal telefono o dal computer

Ora del box 14:32 Data e ora Impostazioni avanzate

È ora di dormire La storia di oggi è già stata raccontata. Riprende alle 15:30.

61% nanna fino alle 15:30

🌙 Cambia la nannaTogli il blocco o sposta l'orario

Il bambino sente il messaggio che avete registrato, poi il box si spegne da solo.

# Colleghiamo il box al WiFi

Serve una volta sola. Dopo, il box si ricollega da solo a ogni accensione.

WiFi casa●●●● WiFi casa 5GHz●●●○ Vicini di casa●●○○

Il box va sulla rete a 2,4 GHz: è quella che arriva più lontano, e le 5 GHz non le vede.

Password del WiFi Nome del box Lingua Fuso orario

Collega il box

Lo troverai poi all'indirizzo babybox-cucina.local dal telefono di casa.

# Data e ora

Servono al controllo genitori: senza, il box applica la regola più severa che avete impostato.

14:32 domenica 18 ottobre 2026

Sincronizzata da internet 4 minuti fa

Fuso orario Imposta a mano

Salva l'ora

Con l'orologio a batteria montato, il box tiene l'ora anche da spento e lontano dal WiFi.
