nicola-milani/babybox/(commit log)

2026-10-17 Documentazione iniziale del progetto box audio
    Specifiche, roadmap, piano di lavoro fino al 20 novembre 2026,
    task firmware 1-8, pinout ESP32-S3, BOM, misure di case/statuine/vinili
    e checklist di verifica del prototipo.
    [bom.csv]
2026-10-17 Modelli 3D parametrici: case, statuine, vinili, provini
    Progetto meccanico completo in OpenSCAD, con un unico file di misure
    (modelli-3d/sorgenti/parametri.scad) e uno script che rigenera gli STL.
    Case 130x130x100: scocca e coperchio in un pezzo unico stampabile
    capovolto senza supporti, fondo avvitato come unica parte smontabile,
    piatto NFC incollato dall'interno, camera chiusa per l'altoparlante.
    Statuine e vinili con sede del tag a 1 mm dal fondo (pausa M600).
    Provino NFC e calibro EN 71-1 come primi pezzi da stampare.
    [_prova.scad, base-statuina.scad, base-statuina.stl, calibro-parti-piccole.scad, calibro-parti-piccole.stl, camera-altoparlante.scad, camera-altoparlante.stl, culla-cursore.scad]
2026-10-17 Progetto elettrico: lista d'ordine e schema di cablaggio
    hardware/ordine.md: cosa comprare subito su Amazon e cosa su AliExpress,
    con i sei componenti da misurare al ricevimento prima di stampare il case.
    hardware/cablaggio.md: alimentazione, collegamenti modulo per modulo,
    ordine di montaggio sulla millefori e verifiche prima di dare tensione.
    Scelte motivate nel documento: regolatore ME6211 al posto di AMS1117/HT7333,
    amplificatore alimentato da VBAT, ricarica a box spento invece del load
    sharing, modulo microSD 3,3 V nativo, modifica della pila sul DS3231.
    [bom.csv]
2026-10-17 Istruzioni di stampa e aggiornamento del piano
    modelli-3d/stampa.md: profilo, orientamento e tempi pezzo per pezzo,
    la pausa a Z=2,0 mm per infilare il tag, inserti a caldo e verifiche
    di sicurezza sui pezzi finiti.
2026-10-17 Script per il fork di ESPuino e il submodule
    firmware/setup-fork.sh crea il fork sull'account GitHub autenticato,
    lo aggancia come firmware/ESPuino e imposta il remote upstream verso
    biologist79/ESPuino per gli allineamenti mensili del task 5.
2026-10-17 Scena d'insieme per i render della documentazione
    [scena.scad]
2026-10-17 Rimuovo un file di prova finito nel commit dei modelli
    [_prova.scad]
2026-10-17 Fork di ESPuino come submodule e configurazione del firmware
    Il fork nicola-milani/ESPuino e' agganciato in firmware/ESPuino sul branch
    main, con upstream verso biologist79/ESPuino per gli allineamenti mensili.
    firmware/config/ contiene i tre file che personalizzano il firmware
    (ambiente PlatformIO per la N16R8, impostazioni generali, pin) e
    applica-config.sh li porta nel fork: i due che ESPuino tiene in .gitignore
    come symlink, quello dei pin come copia. Il fork resta cosi' pulito.
    Verificato leggendo ESPuino 3.1: LPCD, pausa togliendo il tag e salvataggio
    della posizione non sono piu' #define ma impostazioni della web UI, e il
    tipo di lettore ora e' RFID_READER_TYPE_RUNTIME. Documentato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
2026-10-17 Il firmware compila: prima build verde per ESP32-S3 N16R8
    Gate della settimana 0 superato. RAM 14,8%, flash 45,5% della partizione
    app da 6,25 MB con OTA, immagine ESP32-S3 generata.
    Quattro cose scoperte compilando, tutte documentate in firmware/README.md
    e firmware/config/impostazioni-box.md:
    1. PlatformIO 6.2.0 rompe il link di pioarduino: serve la 6.1.19 su Python
    3.12, come la CI di ESPuino.
    2. L'ambiente esp32-s3-devkitc-1 di ESPuino contiene "platform = espressif32",
    che scavalca la piattaforma pinnata: si finisce senza managed_components e
    la build muore su https_server.crt. La loro CI compila solo schede ESP32,
    quindi nessuno lo prova. Il nostro ambiente eredita [env]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
2026-10-17 Scrivo davvero le note che il commit precedente prometteva
    Trappole di compilazione e rischio LPCD in impostazioni-box.md.
2026-10-18 Task 3 fatto: italiano nella web UI e nei log
    Traduzione completa nel fork, sul ramo italiano staccato da master cosi'
    la pull request a monte contiene solo quella: it.json, LogMessages_IT.cpp,
    values.h, processHtml.py e la voce nel selettore della lingua.
    Due strumenti nuovi, entrambi senza hardware:
    - test/verifica-traduzione.py: confronta chiavi e segnaposto con l'inglese,
    simboli e specificatori printf dei messaggi di log (un %s al posto di un
    %u fa crashare il box, non e' un refuso) e controlla selettore e
    processHtml. Scritto prima della traduzione, come da regola del progetto.
    - test/webui-locale/server.py: serve le pagine vere di ESPuino fingendo il
    box, per rivedere la tra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
    [settings-override.h]
2026-10-18 Niente pull request verso progetti altrui
    Decisione del 18 ottobre, messa fra le regole in CLAUDE.md: correzioni e
    traduzione restano nel fork. Il criterio di accettazione del task 3 che
    chiedeva di aprire una PR a monte e' annullato; il ramo italiano resta
    staccato da master perche' tiene la traduzione separata dalle
    personalizzazioni del box e semplifica gli allineamenti del task 5.
2026-10-18 Task 6: il cuore del controllo genitori, con 47 verifiche
    firmware/moduli/controllo-genitori/: decide se il box puo' riprodurre.
    Fasce orarie per giorno (anche quelle che scavalcano la mezzanotte, che
    restano una fascia sola), storie concesse, volume ridotto, dissolvenza
    sull'ultima storia, nanna manuale a tempo o fino al mattino, regola piu'
    restrittiva quando l'ora non e' affidabile.
    Scelta progettuale: dentro non c'e' niente di Arduino. Il modulo riceve
    l'ora e lo stato e restituisce una decisione; lo Stato e' una struttura
    piatta che il box scrivera' tale e quale in NVS. Cosi' le verifiche girano
    sul Mac in un secondo (./firmware/prove.sh) invece che a ogni flash, e
    l'innesto in ESPuino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
2026-10-18 Task 6 completo lato software: regole, innesto, pagina
    Nel fork: il modulo del controllo genitori, i fili verso il box e la
    pagina "Genitori" della web UI. Il modulo si sposta da firmware/moduli/
    dentro al fork, perche' e' li' che ESPuino lo compila; qui restano le 47
    verifiche e lo script che le esegue.
    Il banco di prova della web UI adesso finge anche /genitori, cosi' la
    pagina si rivede e si cronometra senza hardware: ora del box, nanna
    adesso, fasce dei sette giorni.
    Resta da fare, e sta scritto nel task: la prova sul box vero, il modulo
    per il DS3231 (ESPuino non lo supporta: usa l'RTC interno via NTP, quindi
    oggi un box riacceso senza WiFi parte con la regola piu' restrittiva) e
    la d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
2026-10-18 Chiusi i due punti aperti sul firmware, e corretti i GPIO della PSRAM
    Pin della microSD: non erano "provvisori", mancava una chiamata. Sull'S3 i
    pin di SD_MMC passano dalla matrice GPIO e per la variante esp32s3 il core
    Arduino non ne assegna nessuno: senza setPins() la scheda non si monta,
    qualunque GPIO si scelga. Risolto nel fork, 38/39/40 sono definitivi.
    Risveglio LPCD: ridimensionato. Fuori dall'ESP32 ALL_LOW e' un alias
    deprecato di ANY_LOW con lo stesso valore, quindi il risveglio funzionava
    gia'; restava l'avviso, ora tolto. Sul banco resta da provare l'LPCD vero,
    che dipende dal PN5180 e dai suoi ponticelli.
    Correzione che vale per chiunque scelga i pin: con la PSRAM octal della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
2026-10-18 Licenze esplicite e nome del box: babybox
    Il repository e' pubblico e non aveva nessun file di licenza, il che
    significa "tutti i diritti riservati": l'opposto di quello che dichiara
    il README, e incompatibile con il firmware, che deriva da ESPuino ed e'
    GPL. Adesso:
    - LICENSE: GPL-3.0 per firmware, script e documentazione
    - modelli-3d/LICENSE: CC BY-SA 4.0 per sorgenti CAD e STL
    - LICENSE-note.md: cosa vale dove, e perche'
    Le registrazioni audio non stanno qui e restano di chi le ha fatte.
    Il nome di esempio del box passa da faba-cucina a babybox-cucina: "Faba"
    e' un marchio commerciale altrui e questo repository e' pubblico.
2026-10-18 Web UI italiana: NFC al posto di RFID
2026-10-18 Mockup della pagina "casa": il box visto dal genitore
    La web UI di ESPuino ha 155 campi e 11 linguette, e sei funzioni intere
    che il nostro firmware ha spento (LED, encoder, Bluetooth, MQTT, FTP,
    cuffie): e' fatta per chi costruisce il box, non per chi mette a letto
    un bambino.
    Questo e' un mockup cliccabile, servito dal banco di prova su
    http://localhost:8081/casa, per provare i gesti sul telefono prima di
    scrivere la pagina vera nel firmware. Non tocca niente.
    Quattro schermate: casa (il coperchio disegnato dal vero mostra cosa sta
    succedendo, piu' quattro tasti larghi), riposo bloccato con la luna,
    primo avvio (WiFi, nome, lingua, fuso orario) e data/ora. I flussi
    "nuova statuina" e "nu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
2026-10-18 Nella web UI niente arriva da internet
    Il mockup caricava i caratteri da Google Fonts: sbagliato, e proprio nel
    momento peggiore. Al primo avvio il telefono e' collegato alla rete creata
    dal box, che internet non ce l'ha, quindi la pagina sarebbe comparsa senza
    caratteri. ESPuino gia' tiene tutto in locale (html/vendor, html/js) e noi
    dobbiamo fare lo stesso.
    I due caratteri ora stanno nel repository, ritagliati ai soli segni
    dell'italiano con pyftsubset: 92 KB diventano 36 KB, che e' quello che
    finirebbe nella flash del firmware. Hanken Grotesk e' un font variabile,
    quindi un file solo copre tutti i pesi.
    Verificato nel browser: zero richieste fuori dal box.
    Regola messa fra i vincoli in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
2026-10-18 Piano aggiornato allo stato vero, e nasce il task 9
    Il software e' avanti di due settimane (task 3 e 6 chiusi, erano previsti
    per la settimana 1 e la 3), l'hardware non e' partito perche' l'ordine non
    e' stato fatto: tutto il rischio della consegna e' in quella data.
    Il piano adesso dice dove siamo con i numeri veri, elenca il lavoro
    firmware rimasto in ordine di priorita' segnando quale pezzo ha bisogno
    dell'hardware, e aggiorna i piani B (compreso cosa succede se il DS3231
    non arriva).
    Task 9 nuovo: la pagina "casa" per i genitori, nata dall'osservazione che
    la web UI di ESPuino ha 155 campi ed e' fatta per chi costruisce il box.
    Il mockup e' gia' provabile; il task raccoglie anche il pr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
2026-10-18 Fuori il display e-paper
    Lo stato del box lo sanno gia' due canali: il genitore lo legge dalla web
    UI, il bambino ce l'ha in mano (la statuina con l'adesivo, e a due anni non
    si legge comunque). L'unica cosa scoperta era "batteria scarica", e la
    copre l'annuncio vocale che ESPuino sa gia' fare: ora e' obbligatorio nel
    task 4, non piu' facoltativo.
    Si risparmiano 12-18 euro per box, una settimana di lavoro (era il task 2
    della settimana 3) e sei GPIO: 12-17 tornano liberi, e ieri il pinout
    risultava pieno. Cade anche il vincolo "il display non deve mai causare
    salti audio", perche' non c'e' piu' niente che possa causarli.
    Il fronte del case e' chiuso, con la sola griglia dell'altoparlante,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
    [bom.csv, parametri.scad, scocca.scad, scocca.stl, statuina-orso.stl]
2026-10-18 Carte al posto delle statuine, porticina sulla USB, raccoglitori ai lati
    Tre cambi decisi il 18 ottobre, che semplificano parecchio la stampa.
    CARTE. Le storie non stanno piu' su statuine stampate ma su carte di PVC
    CR80 (85,6 x 54) comprate gia' con il tag NTAG213 dentro: niente modello
    da stampare, niente pausa a meta' stampa per infilare l'adesivo, niente
    incavo da progettare. Una statuina costava due ore di stampa l'una; una
    carta costa 0,40 euro e la si disegna con un adesivo sopra. I dischi della
    musica restano stampati: la forma dice il tipo, e un bambino di due anni
    lo impara subito.
    Il vassoio sul coperchio diventa rettangolare, 88 x 62: accetta sia una
    carta sia un disco Ø60. Il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
    [_sezione.scad, base-statuina.stl, bom.csv, libreria.scad, parametri.scad, piatto-nfc.scad, piatto-nfc.stl, raccoglitore-carte.scad]
2026-10-18 Modalita' configurazione col tasto genitori, e un LED di stato
    FUORI CASA. ESPuino apriva gia' la propria rete all'accensione quando
    nessuna rete conosciuta e' a portata, captive portal compreso: il caso
    "accendo il box dai nonni" funzionava da solo. Restavano due buchi, letti
    nel codice: la rete si chiude dopo 5 minuti, e una volta chiusa non si
    riapre perche' l'access point parte solo al primo tentativo dopo l'avvio
    (if initialStart). L'unico modo era spegnere e riaccendere.
    Adesso Wlan_ForceAccessPoint() la apre su richiesta, e la chiama una
    pressione lunga sul tasto genitori: quello incassato sotto la scatola, che
    un bambino non raggiunge. E' l'unica pressione lunga del progetto e ora e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
    [_sezione.scad, bom.csv, parametri.scad, scocca.scad, scocca.stl]
2026-10-18 Aggiorno il puntatore del submodule
2026-10-18 Piano aggiornato: carte, porticina, raccoglitori, LED, modalita' configurazione
    Lo stato di domenica sera, con quello che e' cambiato nel pomeriggio e
    quello che cambia nell'ordine di martedi': niente display, 20 carte CR80 al
    posto degli adesivi, un WS2812 in piu'.
    Il gate della settimana 2 ora dice esplicitamente che il deep sleep sotto
    1 mA va misurato col LED alimentato: e' il punto dove quel LED potrebbe
    costarci il risultato.
    Annotata anche la variante console da viaggio come candidata per una v2,
    con la prova che la decide.
2026-10-18 Console da viaggio: la v2 esiste, e si puo' scegliere con gli STL in mano
    La stampa non e' ancora partita, quindi la variante vale la pena averla
    modellata davvero invece che disegnata: modelli-3d/v2-console/ con tre
    pezzi nuovi (guscio anteriore, guscio posteriore, coperchio del vano) e il
    riuso di pomello, culla, camera e porticina USB dal cubo.
    LA CARTA SI INFILA DI LATO CORTO, un centimetro fuori. E' l'idea di
    Nicola, con una correzione: di lato corto invece che lungo. L'antenna di
    una CR80 e' una spira lungo tutto il bordo, quindi infilandola a meta'
    meta' spira resta fuori dal campo e la lettura diventa un'incognita; con
    un centimetro fuori la spira e' tutta davanti all'antenna. In pi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
    [coperchio-vano.scad, coperchio-vano.stl, parametri-v2.scad, retro-v2.scad, retro-v2.stl, scena-v2.scad, scocca-v2.scad, scocca-v2.stl]
2026-10-18 Console v2 completa: ferrite, sostegni interni, paracolpi, verifica ingombri
    La v2 di ieri sera era un guscio senza niente dentro. Adesso regge i
    componenti come il cubo:
    - cornice del PN5180 con la sede del foglio di ferrite. La ferrite non e'
    uno schermo, e' una scorciatoia per il campo: raccoglie le linee che
    passano dietro l'antenna e le rimanda avanti. Senza, il lettore vede le
    carte riposte nel vano sul retro e fa partire storie da solo.
    - culla della batteria divisa fra i due gusci: chiudendoli il portabatteria
    resta stretto, piu' due asole per una fascetta.
    - colonnine della basetta, sede del TP4056 allineata alla presa, culla e
    collare del cursore.
    - paracolpi-v2: quattro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
    [bom.csv, paracolpi-v2.scad, paracolpi-v2.stl, parametri-v2.scad, retro-v2.scad, retro-v2.stl, scocca-v2.scad, scocca-v2.stl]
2026-10-18 Console v2: il cursore del volume torna sulla faccia
    Era finito sul bordo inferiore nel giro di ieri sera, quando la griglia
    dell'altoparlante stava al centro e sulla faccia restavano 32 mm dove ne
    servono 69. Spostando la griglia a destra (x 32 -> 38) lo spazio c'e', e il
    comando torna dove il bambino lo vede e dove lo voleva il documento della
    variante: frontale, in basso a sinistra, con le icone del volume incise ai
    due capi.
    Sta a z=34 e non piu' in basso perche' a z=20 avrebbe sbattuto contro il
    braccio basso della culla della batteria. Quella collisione il verificatore
    non la vedeva: confrontava la batteria ma non le sue culle. Adesso le
    confronta (14 pezzi invece di 12), con una list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
    [parametri-v2.scad, scocca-v2.scad, scocca-v2.stl]
2026-10-18 Console v2: i comandi che mancavano - interruttore, tasto genitori, porticina USB, sfiati
    Confronto comando per comando con il cubo: nella console ne mancavano
    quattro. Tre erano veri buchi, non scelte.
    - Interruttore generale e tasto genitori: sul cubo stanno sotto il fondo,
    dove la mano di un bambino non arriva mentre gioca. Qui un sotto non
    c'e', quindi vanno sul retro, nella fascia sotto il vano: e' la faccia
    che guarda il tavolo quando la console e' appoggiata, e per premere il
    tasto genitori bisogna sollevarla, che e' il gesto giusto.
    - Porticina della USB: il foro c'era, la guida no, e il README diceva di
    riusare quella del cubo. Non ci sta: il bordo e' profondo 19 mm e que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
    [parametri-v2.scad, retro-v2.scad, retro-v2.stl, scocca-v2.scad, scocca-v2.stl, sportello-usb-v2.scad, sportello-usb-v2.stl]
2026-10-18 Console v2: scena a colori per i render, e le carte nel vano stanno di piatto
    scena-colori.scad mette insieme i pezzi stampati e i componenti comprati -
    tasti, pomello, altoparlante, interruttore, carta infilata - e li colora
    come verrebbero davvero: corpo bianco, comandi a colori, paracolpi in TPU
    antracite. Serve ai render del README, non si stampa.
    Guardando il primo render sono venute fuori due cose:
    - la carta della scena finiva dentro il guscio invece di sporgere:
    piastra() estrude da zero e non e' centrata. Stessa riga sbagliata anche
    in scena-v2.scad.
    - nel vano c'erano sei divisori per tenere le carte in piedi. In piedi non
    ci stanno e non ci starebbero mai: il vano e' profo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
    [paracolpi-v2.scad, paracolpi-v2.stl, retro-v2.scad, retro-v2.stl, scena-colori.scad, scena-v2.scad]
2026-10-18 Render a colori della console nel README
    Tre immagini generate da scena-colori.scad: davanti, dietro chiuso,
    dietro aperto con le carte. Stanno in modelli-3d/v2-console/immagini/ e
    nel README c'e' il comando per rifarle quando cambia un pezzo.
2026-10-18 Console v2: la carta entra tutta, e si sfila da una tacca sulla faccia
    Idea di Nicola: azzerare la sporgenza e dare la presa con uno scasso sul
    pannello frontale. Funziona, e si porta dietro tre vantaggi oltre
    all'estetica.
    - Una carta che sporge di un centimetro e' la prima cosa che si piega
    quando la console va in borsa, ed e' una leva comoda in mano a un
    bambino. A filo non c'e' niente da piegare.
    - La tacca (34 x 18) fa da finestra sul disegno della carta: si continua a
    vedere quale storia e' dentro, anzi si vede il disegno invece del bordo.
    - Entrando tutta, la spira del tag e' interamente davanti all'antenna: la
    lettura puo' solo migliorare.
    Costava spazio: la tasca passa da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
    [parametri-v2.scad, scena-colori.scad, scena-v2.scad, scocca-v2.scad, scocca-v2.stl]
2026-10-18 Piano: stato al 18 ottobre sera, 18 STL e la console v2 alla pari
    E una nota sull'ordine: non dipende dalla scelta fra cubo e console,
    perche' l'elettronica e il pinout sono gli stessi. Ferrite e TPU sono gli
    unici pezzi della sola console, 20 euro in tutto.
2026-10-18 Lista d'ordine rifatta per un pezzo solo
    Niente scorte: le quantita' sono quelle di un box, e dove c'e' scritto
    'conf. da N' e' perche' quel componente sfuso non si compra.
    Cambio di criterio sul dove: prima i pezzi critici andavano su Amazon e la
    minuteria su AliExpress per risparmiare. Con un pezzo solo quel risparmio
    vale una ventina di euro, mentre un componente che manca in settimana 2
    costa molto di piu'. Quindi regolatore, portabatteria, interruttore,
    WS2812, tasto genitori, passivi, basetta, inserti e cablaggio passano in
    parte A. Su AliExpress restano il DS3231 (opzionale: ESPuino usa l'RTC
    interno via NTP) e le viti di sicurezza (se tardano si usano le M2.5
    normali).
    Totale 145-2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
    [bom.csv]
2026-10-18 Ordine ibrido: nove voci su Amazon, il resto su AliExpress
    La lista non e' piu' divisa per prezzo ma per conseguenza del guasto. Su
    Amazon finisce quello che sta sul percorso critico delle settimane 1 e 2
    piu' i due pezzi dove il rischio non e' il ritardo ma la sicurezza e i
    dati: la 18650 (celle sfuse spesso non spedibili verso l'UE, e il mercato
    e' pieno di celle rimarchiate) e la microSD (contraffatte).
    Oltre ai sei pezzi ovvi ne ho aggiunti tre, tutti per M2: il regolatore
    (il deep sleep sotto 1 mA non si misura sulla DevKit alimentata da USB),
    il portabatteria (serve al test di autonomia, e alla cella non si salda) e
    il WS2812 (M2 chiede la misura col LED alimentato).
    Con la sola part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
    [bom.csv]
2026-10-18 Lista d'acquisto coi link, e un problema sull'altoparlante
    acquisti.md ha i link verificati il 19 ottobre dove esistono e i link di
    ricerca gia' impostata dove un prodotto non valeva la pena indicarlo (le
    inserzioni muoiono, le ricerche no). lista-acquisti.html e' la stessa cosa
    da telefono, con le caselle da spuntare.
    Cercando e' saltato fuori che l'altoparlante come l'avevamo specificato
    non si compra: i 'Ø40 4 ohm 3W' su Amazon sono alti 18-20 mm, e il guscio
    anteriore della console e' profondo 26 col tubo che ne occupa 12. Serve il
    tipo ultrasottile da tablet, che sta su AliExpress. Visto che e' sul
    percorso critico: quello sottile li', piu' uno qualsiasi su Amazon come
    riserva da 8 eu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
2026-10-18 Niente font da internet nelle due pagine HTML
    Il controllo di sicurezza ha segnalato i tag verso fonts.googleapis.com in
    lista-acquisti.html: richieste a terzi senza integrity, e una pagina che
    offline non si legge come dovrebbe. Vale anche per console.html, che
    aveva gli stessi tag.
    La regola del progetto e' gia' scritta in CLAUDE.md - niente risorse da
    internet - ed era nata per la web UI del box, dove al primo avvio
    internet non c'e' proprio. Queste due pagine non girano sul box, ma non
    c'e' motivo di fare un'eccezione per un carattere: ora usano le famiglie
    di sistema, serif per i titoli e sans per il testo. Zero richieste
    esterne, e la lista della spesa si apre anche in un negozio senz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
2026-10-18 RC522 come piano B, comprato subito invece che quando serve
    Nicola non trova il PN5180 e trova l'RC522. Cosa cambia: le carte no
    (NTAG213 e' ISO 14443A, lo leggono entrambi), il firmware nemmeno
    (RFID_READER_TYPE_RUNTIME e' una voce della web UI, 3 = PN5180, 1 =
    MFRC522 SPI, nessuna ricompilazione). Cambia il risveglio: l'LPCD ce l'ha
    solo il PN5180, quindi col solo RC522 il box dev'essere gia' sveglio
    quando arriva la carta e il bambino prima preme un tasto.
    Quindi l'RC522 passa dalla sezione 'non ordinare adesso' alla parte A: un
    piano B comprato quando serve non e' un piano B. E un PN5180 va nel
    carrello AliExpress (B17), dove abbondano a 5-8 euro. In settimana 2 si
    decide col banco, ave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
2026-10-18 Il carico esce da OUT+/OUT- del TP4056, non dai poli della cella
    Guardando una batteria che Nicola stava per comprare e' saltato fuori un
    buco nello schema: il carico partiva direttamente dalla cella, e il DW01
    sta fra B- e OUT-. Prendendo l'alimentazione dai poli lo si salta, quindi
    l'unica protezione da sovrascarica era la cella stessa - e se la cella non
    ce l'ha, non c'e' nessuna protezione: una cella dimenticata accesa scende
    sotto i 2,5 V, si rovina, e ricaricarla dopo e' pericoloso.
    Spostando il carico su OUT+/OUT- la protezione c'e' sempre, anche con una
    cella nuda. Costa 100 mOhm, invisibili a 150 mA. La ricarica a box spento
    resta come prima.
    Di conseguenza nella lista 'protetta'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
    [bom.csv]
2026-10-18 La culla della batteria accetta sia il portabatteria sia la cella precablata
    Su Amazon le 18650 nude si trovano male: la vendita di celle sfuse e'
    limitata, e quasi tutto quello che esce e' un pacco gia' precablato con
    fili e connettore. Invece di continuare a scartare inserzioni, il modello
    adesso accetta tutt'e due: BATT_TIPO in parametri.scad, 'portabatteria'
    (cella nuda in un supporto a molle, 24x78x20) oppure 'cella' (pacco
    precablato, 19,5 x 72, tenuto dalle fascette). Una riga, si rigenera, le
    culle nei due gusci si rifanno da sole.
    Il precablato ha anche un vantaggio vero: niente contatti a molla, che in
    un oggetto che cade sono la causa numero uno dei falsi contatti.
    Per farlo fun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
    [parametri-v2.scad, parametri.scad, retro-v2.scad, retro-v2.stl, scocca-v2.scad]
2026-10-18 Batteria: nkon, Samsung nuova, mai 'reclaimed'
    35E (3500), 30Q (3000) o 29E (2900): tutte e tre vanno bene, tutte flat
    top da 65 mm, tutte senza protezione - che adesso non e' un problema,
    perche' il DW01 protegge da quando il carico esce da OUT+/OUT-. La
    corrente massima dichiarata non ci riguarda: il box tira 0,15 A.
    Da evitare le 'reclaimed': celle Samsung vere ma recuperate da pacchi
    usati, con un numero di cicli ignoto.
    [bom.csv]
